OLIMEX/RP2350-PICO2-BB48/DOCUMENTS/BB-PICO2-2.jpg

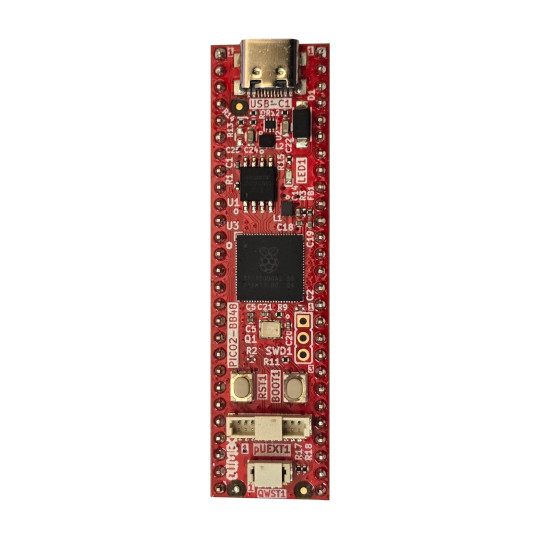
DOCUMENTS/BB-PICO2-2.jpg
