OLIMEX/RP2350-PICO2-BB48/README.md

# RP2350-PICO2-BB48
Raspberry Pi RP2350 PICO2 board with all 48 ports exposed, PSRAM 8MB, Flash 16MB
