OLIMEX/RP2350-PICO2-BB48/DOCUMENTS/RP2350-PICO2-BB48-pinout.png

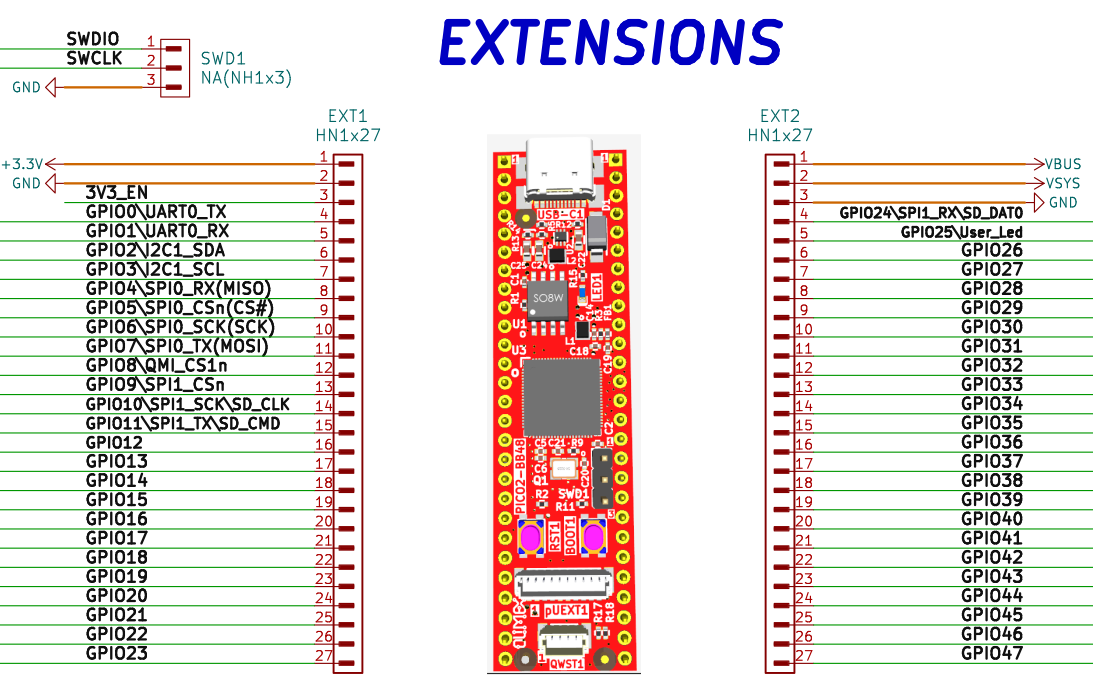
DOCUMENTS/RP2350-PICO2-BB48-pinout.png
