OLIMEX/RP2350-PICO2-BB48/HARDWARE/RP2350-PICO2-BB48.REV.A/PICO2-BB48_Rev_A.pdf

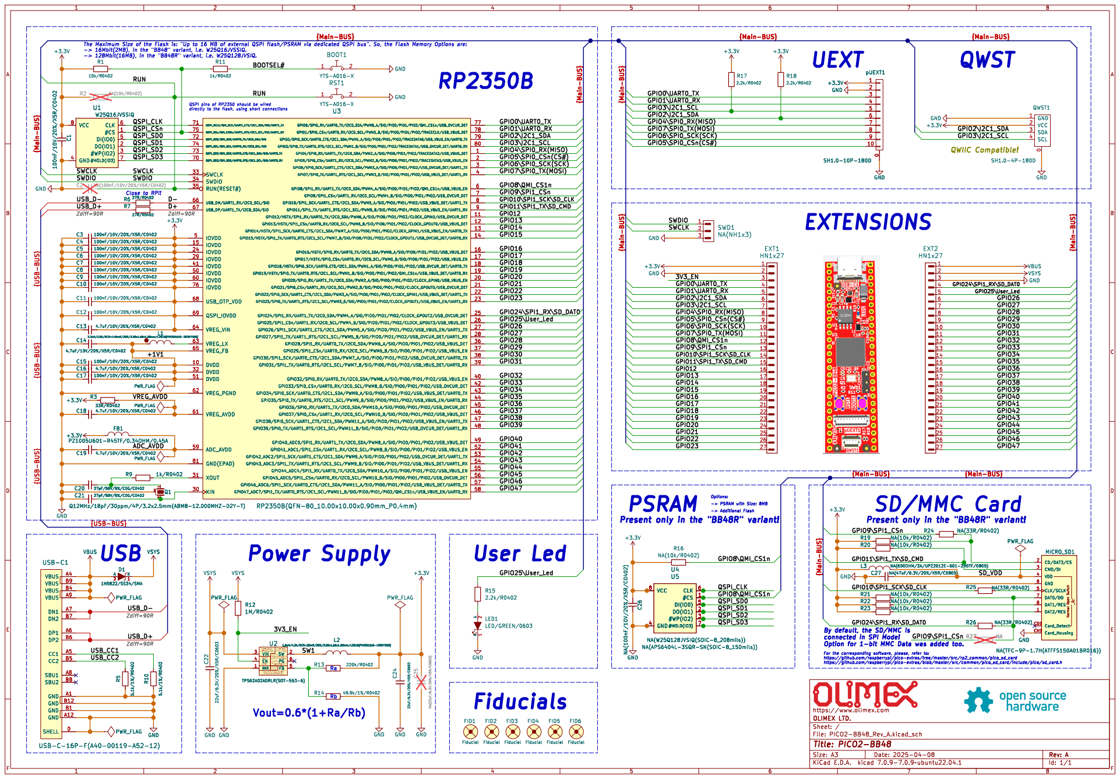
[picture p4: page 1]

{Main-BUS}
directly to the flash, using short connections Vout=0.6*(1+Ra/Rb)
U3 RP2350B(QFN-80_10.00x10.00x0.90mm_P0.4mm)

QSPI pins of RP2350 should be wired

SD/MMC Card Options: Fiducials

Present only in the "BB48R" variant!

Cout=(10~22)uF/6.3V/X5Rþÿ(Vout"e1.8V). 22uFRecommended! Cout=22uF/6.3V/X5Rþÿ(1.2V"dVout<1.8V) Cout=44uF/6.3V/X5Rþÿ(0.6V"dVout<1.2V) DCR<50mR

In casea loweroutputrippleisdesired,higheroutputcapacitancecanhelpreducetheripple. Lx=1.0uH

https://github.com/raspberrypi/pico-extras/blob/master/src/common/pico_sd_card/include/pico/sd_card.h

Donotfloat. Enablecontrol. FB Input Current,I(FB)=100nA(max) FeedbackReferenceVoltage,V(REF)=0.6V
Rb mustnotbehigherthanþÿ100k© toprovideacceptablenoisesensitivity. ShutdownCurrentI(SHDN)=0.01-2uA
