OLIMEX/RP2350-PICO2-BB48/HARDWARE/RP2350-PICO2-BB48.REV.A/PICO2-BB48_Rev_A.kicad_pcb

## KiCad design HARDWARE/RP2350-PICO2-BB48.REV.A/PICO2-BB48_Rev_A.kicad_pcb (2025-09-22)

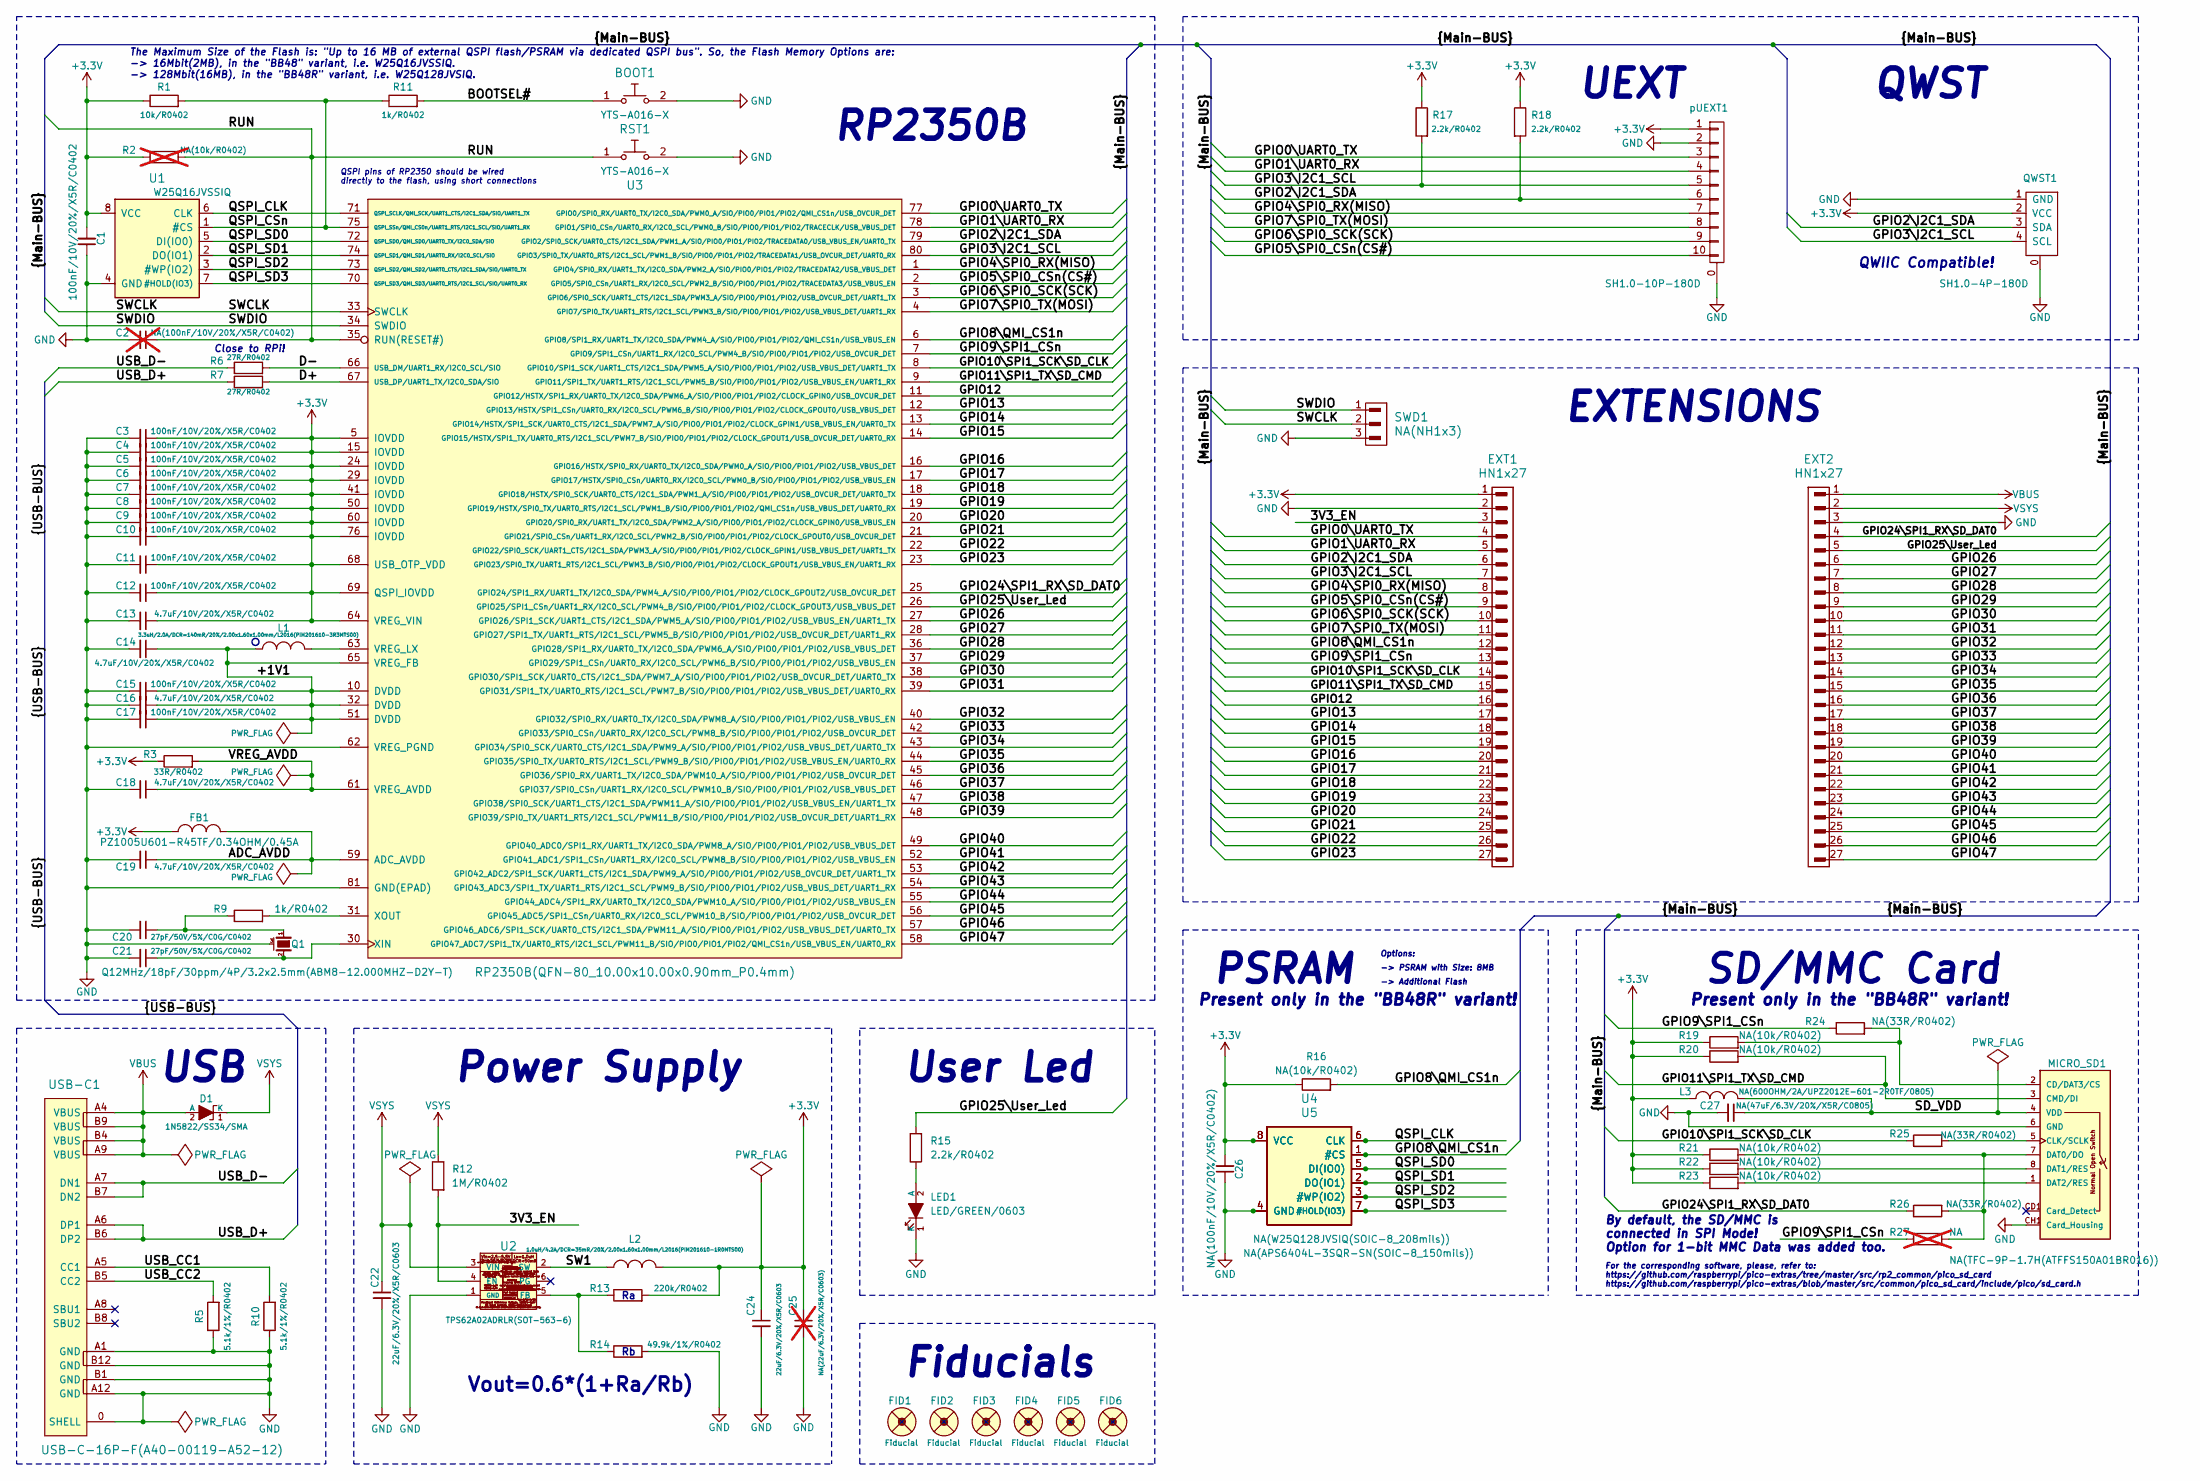
[picture p5: schematic PICO2-BB48_Rev_A.kicad_sch, PICO2-BB48]

Parts:
BOOT1: YTS-A016-X
C1, C3, C4, C5, C6, C7, C8, C9, C10, C11, C12, C15, C17: 100nF/10V/20%/X5R/C0402; C_0402_5MIL_DWS
C2: NA(100nF/10V/20%/X5R/C0402); C_0402_5MIL_DWS; not fitted
C13, C14, C16, C18, C19: 4.7uF/10V/20%/X5R/C0402; C_0402_5MIL_DWS
C20, C21: 27pF/50V/5%/C0G/C0402; C_0402_5MIL_DWS
C22, C24: 22uF/6.3V/20%/X5R/C0603; C_0603_5MIL_DWS
C25: NA(22uF/6.3V/20%/X5R/C0603); C_0603_5MIL_DWS; not fitted
C26: NA(100nF/10V/20%/X5R/C0402); C_0402_5MIL_DWS
C27: NA(47uF/6.3V/20%/X5R/C0805); C_0805_5MIL_DWS
D1: 1N5822/SS34/SMA; SMA-KA
EXT1, EXT2: HN1x27
FB1: PZ1005U601-R45TF/0.34OHM/0.45A; L_0402_5MIL_DWS
FID1, FID4: Fiducial; Fiducial1x3_Paste
FID2, FID3, FID5, FID6: Fiducial; Fiducial1x3
L1: 3.3uH/2.0A/DCR=140mR/20%/2.00x1.60x1.00mm/L2016(P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; L_2016_MM
L2: 1.0uH/4.2A/DCR=35mR/20%/2.00x1.60x1.00mm/L2016(PI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; L_2016_MM
L3: NA(600OHM/2A/UPZ2012E-601-2R0TF/0805); L_0805_5MIL_DWS
LED1: LED/GREEN/0603; LED_0603_KA
MICRO_SD1: NA(TFC-9P-1.7H(ATFFS150A01BR016)); uSD(TFC-9P-1.xH(ATFFS150A01BR016))
Q1: Q12MHz/18pF/30ppm/4P/3.2x2.5mm(ABM8-12.000MHZ-D2Y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; TSX-3.2x2.5mm_GND(3)
QWST1: SH1.0-4P-180D; BM04B-SRSS-TB
R1: 10k/R0402; R_0402_5MIL_DWS
R2: NA(10k/R0402); R_0402_5MIL_DWS; not fitted
R3: 33R/R0402; R_0402_5MIL_DWS
R5, R10: 5.1k/1%/R0402; R_0402_5MIL_DWS
R6, R7: 27R/R0402; R_0402_5MIL_DWS
R9, R11: 1k/R0402; R_0402_5MIL_DWS
R12: 1M/R0402; R_0402_5MIL_DWS
R13: 220k/R0402; R_0402_5MIL_DWS
R14: 49.9k/1%/R0402; R_0402_5MIL_DWS
R15, R17, R18: 2.2k/R0402; R_0402_5MIL_DWS
R16, R19, R20, R21, R22, R23: NA(10k/R0402); R_0402_5MIL_DWS
R24, R25, R26: NA(33R/R0402); R_0402_5MIL_DWS
R27: NA; R_0402_5MIL_DWS; not fitted
RST1: YTS-A016-X
SWD1: NA(NH1x3); HN1x3
U1: W25Q16JVSSIQ; SO-8_208mil
U2: TPS62A02ADRLR(SOT-563-6); SOT-563-6
U3: RP2350B(QFN-80_10.00x10.00x0.90mm_P0.4mm); QFN-80_10.00x10.00x0.90mm_P0.4mm
U4: NA(W25Q128JVSIQ(SOIC-8_208mils)); SO-8_208mil
U5: NA(APS6404L-3SQR-SN(SOIC-8_150mils)); SO-8
USB-C1: USB-C-16P-F(A40-00119-A52-12); USB2.0_TYPE-C(A40-00119-A52-12)_Paste
pUEXT1: SH1.0-10P-180D; BM10B-SRSS-TB

Connections:
+3.3V: C1.2, C3.1, C4.1, C5.1, C6.1, C7.1, C8.1, C9.1, C10.1, C11.1, C12.1, C13.1, C24.1, C25.1, C26.2, EXT1.1, FB1.1, L2.1, L3.1, QWST1.2 (VCC), R1.1, R2.1, R3.1, R13.2, R16.1, R17.1, R18.1, R19.1, R20.1, R21.1, R22.1, R23.1, U1.8 (VCC), U3.5 (IOVDD), U3.15 (IOVDD), U3.24 (IOVDD), U3.29 (IOVDD), U3.41 (IOVDD), U3.50 (IOVDD), U3.60 (IOVDD), U3.64 (VREG_VIN), U3.68 (USB_OTP_VDD), U3.69 (QSPI_IOVDD), U3.76 (IOVDD), U4.8 (VCC), U5.8 (VCC), pUEXT1.1
/3V3_EN: EXT1.3, R12.2, U2.4 (EN)
/+1V1: C14.1, C15.1, C16.1, C17.1, L1.1, U3.10 (DVDD), U3.32 (DVDD), U3.51 (DVDD), U3.65 (VREG_FB)
/ADC_AVDD: C19.1, FB1.2, U3.59 (ADC_AVDD)
/BOOTSEL#: BOOT1.1, R11.2
/D+: R7.2, U3.67 (USB_DP/UART1_TX/I2C0_SDA/SIO)
/D-: R6.2, U3.66 (USB_DM/UART1_RX/I2C0_SCL/SIO)
/GPIO0\UART0_TX: EXT1.4, U3.77 (GPIO0/SPI0_RX/UART0_TX/I2C0_SDA/PWM0_A/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), pUEXT1.3
/GPIO1\UART0_RX: EXT1.5, U3.78 (GPIO1/SPI0_CSn/UART0_RX/I2C0_SCL/PWM0_B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), pUEXT1.4
/GPIO2\I2C1_SDA: EXT1.6, QWST1.3 (SDA), R18.2, U3.79 (GPIO2/SPI0_SCK/UART0_CTS/I2C1_SDA/PWM1_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), pUEXT1.6
/GPIO3\I2C1_SCL: EXT1.7, QWST1.4 (SCL), R17.2, U3.80 (GPIO3/SPI0_TX/UART0_RTS/I2C1_SCL/PWM1_B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), pUEXT1.5
/GPIO4\SPI0_RX(MISO): EXT1.8, U3.1 (GPIO4/SPI0_RX/UART1_TX/I2C0_SDA/PWM2_A/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), pUEXT1.7
/GPIO5\SPI0_CSn(CS#): EXT1.9, U3.2 (GPIO5/SPI0_CSn/UART1_RX/I2C0_SCL/PWM2_B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), pUEXT1.10
/GPIO6\SPI0_SCK(SCK): EXT1.10, U3.3 (GPIO6/SPI0_SCK/UART1_CTS/I2C1_SDA/PWM3_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), pUEXT1.9
/GPIO7\SPI0_TX(MOSI): EXT1.11, U3.4 (GPIO7/SPI0_TX/UART1_RTS/I2C1_SCL/PWM3_B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), pUEXT1.8
/GPIO8\QMI_CS1n: EXT1.12, R16.2, U3.6 (GPIO8/SPI1_RX/UART1_TX/I2C0_SDA/PWM4_A/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), U4.1 (#CS), U5.1 (#CS)
/GPIO9\SPI1_CSn: EXT1.13, R24.1, R27.1, U3.7 (GPIO9/SPI1_CSn/UART1_RX/I2C0_SCL/PWM4_B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)
/GPIO10\SPI1_SCK\SD_CLK: EXT1.14, R25.1, U3.8 (GPIO10/SPI1_SCK/UART1_CTS/I2C1_SDA/PWM5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)
/GPIO11\SPI1_TX\SD_CMD: EXT1.15, MICRO_SD1.3 (CMD/DI), R20.2, U3.9 (GPIO11/SPI1_TX/UART1_RTS/I2C1_SCL/PWM5_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)
/GPIO12: EXT1.16, U3.11 (GPIO12/HSTX/SPI1_RX/UART0_TX/I2C0_SDA/P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)
/GPIO13: EXT1.17, U3.12 (GPIO13/HSTX/SPI1_CSn/UART0_RX/I2C0_SCL/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)
/GPIO14: EXT1.18, U3.13 (GPIO14/HSTX/SPI1_SCK/UART0_CTS/I2C1_SDA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)
/GPIO15: EXT1.19, U3.14 (GPIO15/HSTX/SPI1_TX/UART0_RTS/I2C1_SCL/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)
/GPIO16: EXT1.20, U3.16 (GPIO16/HSTX/SPI0_RX/UART0_TX/I2C0_SDA/P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)
/GPIO17: EXT1.21, U3.17 (GPIO17/HSTX/SPI0_CSn/UART0_RX/I2C0_SCL/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)
/GPIO18: EXT1.22, U3.18 (GPIO18/HSTX/SPI0_SCK/UART0_CTS/I2C1_SDA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)
/GPIO19: EXT1.23, U3.19 (GPIO19/HSTX/SPI0_TX/UART0_RTS/I2C1_SCL/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)
/GPIO20: EXT1.24, U3.20 (GPIO20/SPI0_RX/UART1_TX/I2C0_SDA/PWM2_A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)
/GPIO21: EXT1.25, U3.21 (GPIO21/SPI0_CSn/UART1_RX/I2C0_SCL/PWM2_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)
/GPIO22: EXT1.26, U3.22 (GPIO22/SPI0_SCK/UART1_CTS/I2C1_SDA/PWM3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)
/GPIO23: EXT1.27, U3.23 (GPIO23/SPI0_TX/UART1_RTS/I2C1_SCL/PWM3_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)
/GPIO24\SPI1_RX\SD_DAT0: EXT2.4, R26.1, U3.25 (GPIO24/SPI1_RX/UART1_TX/I2C0_SDA/PWM4_A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)
/GPIO25\User_Led: EXT2.5, R15.2, U3.26 (GPIO25/SPI1_CSn/UART1_RX/I2C0_SCL/PWM4_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)
/GPIO26: EXT2.6, U3.27 (GPIO26/SPI1_SCK/UART1_CTS/I2C1_SDA/PWM5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)
/GPIO27: EXT2.7, U3.28 (GPIO27/SPI1_TX/UART1_RTS/I2C1_SCL/PWM5_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)
/GPIO28: EXT2.8, U3.36 (GPIO28/SPI1_RX/UART0_TX/I2C0_SDA/PWM6_A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)
/GPIO29: EXT2.9, U3.37 (GPIO29/SPI1_CSn/UART0_RX/I2C0_SCL/PWM6_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)
/GPIO30: EXT2.10, U3.38 (GPIO30/SPI1_SCK/UART0_CTS/I2C1_SDA/PWM7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)
/GPIO31: EXT2.11, U3.39 (GPIO31/SPI1_TX/UART0_RTS/I2C1_SCL/PWM7_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)
/GPIO32: EXT2.12, U3.40 (GPIO32/SPI0_RX/UART0_TX/I2C0_SDA/PWM8_A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)
/GPIO33: EXT2.13, U3.42 (GPIO33/SPI0_CSn/UART0_RX/I2C0_SCL/PWM8_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)
/GPIO34: EXT2.14, U3.43 (GPIO34/SPI0_SCK/UART0_CTS/I2C1_SDA/PWM9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)
/GPIO35: EXT2.15, U3.44 (GPIO35/SPI0_TX/UART0_RTS/I2C1_SCL/PWM9_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)
/GPIO36: EXT2.16, U3.45 (GPIO36/SPI0_RX/UART1_TX/I2C0_SDA/PWM10_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)
/GPIO37: EXT2.17, U3.46 (GPIO37/SPI0_CSn/UART1_RX/I2C0_SCL/PWM10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)
/GPIO38: EXT2.18, U3.47 (GPIO38/SPI0_SCK/UART1_CTS/I2C1_SDA/PWM1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)
/GPIO39: EXT2.19, U3.48 (GPIO39/SPI0_TX/UART1_RTS/I2C1_SCL/PWM11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)
/GPIO40: EXT2.20, U3.49 (GPIO40_ADC0/SPI1_RX/UART1_TX/I2C0_SDA/P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)
/GPIO41: EXT2.21, U3.52 (GPIO41_ADC1/SPI1_CSn/UART1_RX/I2C0_SCL/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)
/GPIO42: EXT2.22, U3.53 (GPIO42_ADC2/SPI1_SCK/UART1_CTS/I2C1_SDA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)
/GPIO43: EXT2.23, U3.54 (GPIO43_ADC3/SPI1_TX/UART1_RTS/I2C1_SCL/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)
/GPIO44: EXT2.24, U3.55 (GPIO44_ADC4/SPI1_RX/UART0_TX/I2C0_SDA/P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)
/GPIO45: EXT2.25, U3.56 (GPIO45_ADC5/SPI1_CSn/UART0_RX/I2C0_SCL/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)
/GPIO46: EXT2.26, U3.57 (GPIO46_ADC6/SPI1_SCK/UART0_CTS/I2C1_SDA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)
/GPIO47: EXT2.27, U3.58 (GPIO47_ADC7/SPI1_TX/UART0_RTS/I2C1_SCL/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)
/QSPI_CLK: U1.6 (CLK), U3.71 (QSPI_SCLK/QMI_SCK/UART1_CTS/I2C1_SDA/SI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), U4.6 (CLK), U5.6 (CLK)
/QSPI_CSn: R1.2, R11.1, U1.1 (#CS), U3.75 (QSPI_SSn/QMI_CS0n/UART1_RTS/I2C1_SCL/SI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)
/QSPI_SD0: U1.5 (DI(IO0)), U3.72 (QSPI_SD0/QMI_SD0/UART0_TX/I2C0_SDA/SIO), U4.5 (DI(IO0)), U5.5 (DI(IO0))
/QSPI_SD1: U1.2 (DO(IO1)), U3.74 (QSPI_SD1/QMI_SD1/UART0_RX/I2C0_SCL/SIO), U4.2 (DO(IO1)), U5.2 (DO(IO1))
/QSPI_SD2: U1.3 (#WP(IO2)), U3.73 (QSPI_SD2/QMI_SD2/UART0_CTS/I2C1_SDA/SIO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), U4.3 (#WP(IO2)), U5.3 (#WP(IO2))
/QSPI_SD3: U1.7 (#HOLD(IO3)), U3.70 (QSPI_SD3/QMI_SD3/UART0_RTS/I2C1_SCL/SIO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), U4.7 (#HOLD(IO3)), U5.7 (#HOLD(IO3))
/RUN: C2.1, R2.2, RST1.1, U3.35 (RUN(RESET#))
/SD_VDD: C27.1, L3.2, MICRO_SD1.4 (VDD)
/SW1: L2.2, U2.2 (SW)
/SWCLK: SWD1.2, U3.33 (SWCLK)
/SWDIO: SWD1.1, U3.34 (SWDIO)
/USB_CC1: R10.2, USB-C1.A5 (CC1)
/USB_CC2: R5.2, USB-C1.B5 (CC2)
/USB_D+: R7.1, USB-C1.A6 (DP1), USB-C1.B6 (DP2)
/USB_D-: R6.1, USB-C1.A7 (DN1), USB-C1.B7 (DN2)
/VREG_AVDD: C18.1, R3.2, U3.61 (VREG_AVDD)
GND: BOOT1.2, C1.1, C2.2, C3.2, C4.2, C5.2, C6.2, C7.2, C8.2, C9.2, C10.2, C11.2, C12.2, C13.2, C14.2, C15.2, C16.2, C17.2, C18.2, C19.2, C20.2, C21.2, C22.2, C24.2, C25.2, C26.1, C27.2, EXT1.2, EXT2.3, LED1.1 (K), MICRO_SD1.6 (GND), MICRO_SD1.CH1 (Card_Housing), Q1.3 (case), QWST1.0, QWST1.1 (GND), R5.1, R10.1, R14.2, RST1.2, SWD1.3, U1.4 (GND), U2.1 (GND), U3.62 (VREG_PGND), U3.81 (GND(EPAD)), U4.4 (GND), U5.4 (GND), USB-C1.0 (SHELL), USB-C1.A1 (GND), USB-C1.A12 (GND), USB-C1.B1 (GND), USB-C1.B12 (GND), pUEXT1.0, pUEXT1.2
unnamed: C20.1, Q1.1, R9.1
unnamed: LED1.2 (A), R15.1
unnamed: MICRO_SD1.2 (CD/DAT3/CS), R19.2, R24.2
unnamed: MICRO_SD1.5 (CLK/SCLK), R25.2
unnamed: MICRO_SD1.7 (DAT0/DO), R21.2, R26.2, R27.2
unnamed: MICRO_SD1.8 (DAT1/RES), R22.2
unnamed: MICRO_SD1.1 (DAT2/RES), R23.2
unnamed: R13.1, R14.1, U2.5 (FB)
unnamed: L1.2, U3.63 (VREG_LX)
unnamed: C21.1, Q1.2, U3.30 (XIN)
unnamed: R9.2, U3.31 (XOUT)
VBUS: D1.2 (A), EXT2.1, USB-C1.A4 (VBUS), USB-C1.A9 (VBUS), USB-C1.B4 (VBUS), USB-C1.B9 (VBUS)
VSYS: C22.1, D1.1 (K), EXT2.2, R12.1, U2.3 (VIN)

Notes on the sheet:
Present only in the "BB48R" variant!
EXTENSIONS
QSPI pins of RP2350 should be wired directly to the flash, using short connections
-> PSRAM with Size: 8MB
By default, the SD/MMC is connected in SPI Mode! Option for 1-bit MMC Data was added too.
The Maximum Size of the Flash is: "Up to 16 MB of external QSPI flash/PSRAM via dedicated QSPI bus". So, the Flash Memory Options are: -> 16Mbit(2MB), in the "BB48" variant, i.e. W25Q16JVSSIQ. -> 128Mbit(16MB), in the "BB48R" variant, i.e. W25Q128JVSIQ.
SD/MMC Card
QWST
USB
User Led
For the corresponding software, please, refer to: https://github.com/raspberrypi/pico-extras/tree/master/src/rp2_common/pico_sd_card https://github.com/raspberrypi/pico-extras/blob/master/src/common/pico_sd_card/include/pico/sd_card.h
Options:
-> Additional Flash
QWIIC Compatible!
Close to RPi!
RP2350B
Vout=0.6*(1+Ra/Rb)
Power Supply
PSRAM
Fiducials
UEXT

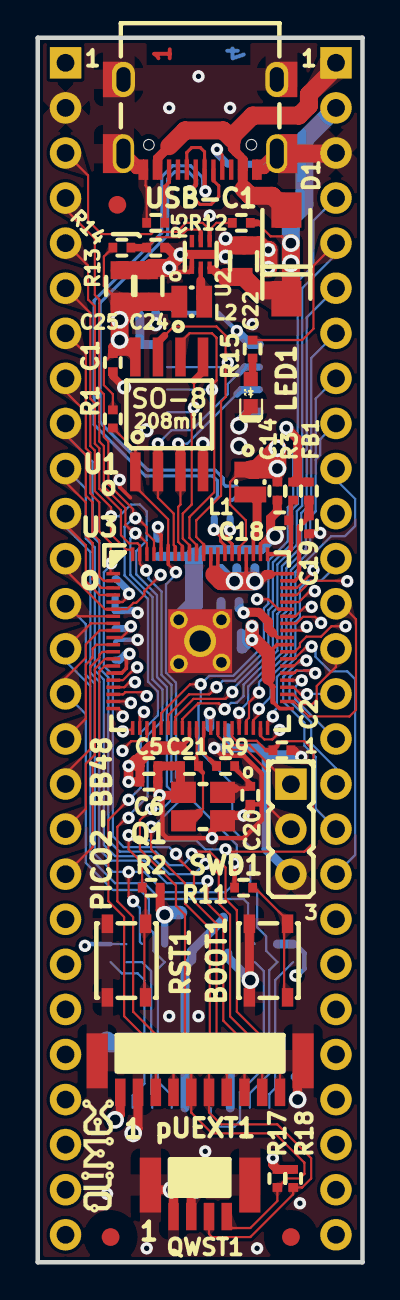
[picture p6: board PICO2-BB48_Rev_A.kicad_pcb from above]

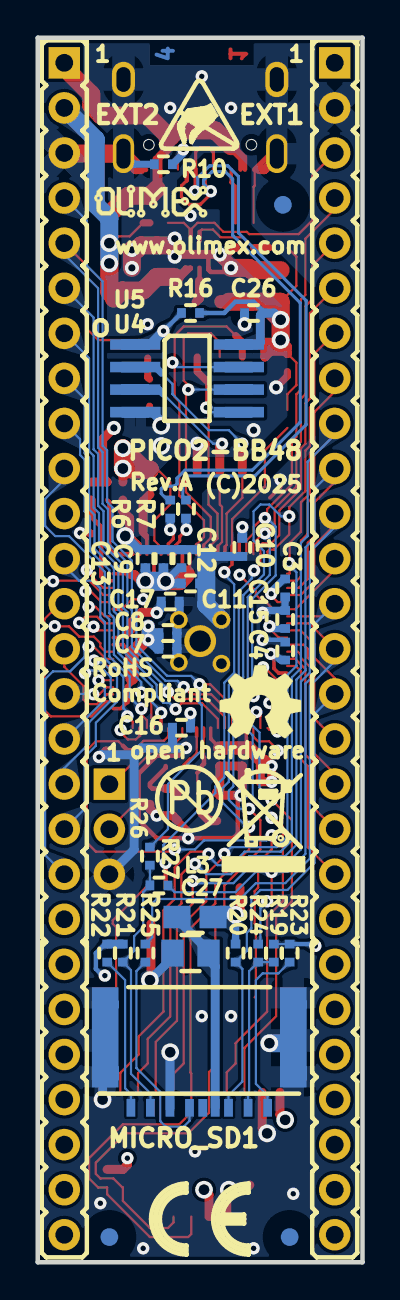
[picture p7: board PICO2-BB48_Rev_A.kicad_pcb from below]

Board: 4 copper layers, 18.3 x 69.0 mm, 85 parts (42 on the bottom side), 85 nets.

Other parts of the board:
Logo_OLIMEX_80, Logo_OLIMEX_80-Bot: Logo_OLIMEX_80
Sign_Antistatic_Small: Sign_Antistatic; Sign_Antistatic_4.5mmX2.8mm
Sign_CE: CE_Sign
Sign_OSHW_7.3x6.0mm: Sign_OSHW_7.3x6.0mm; Sign_OSHW_7.3x6.0mmn
Sign_PB-Free: Sign_PB-Free
Sign_RecycleBin_1: Sign_RecycleBin_1
