OLIMEX/RP2350-PICO2-BB48/(notices)

Notices in the files:
HARDWARE/RP2350-PICO2-BB48.REV.A/PICO2-BB48_Rev_A.kicad_pcb:
(C)2025
